MEG3832/Luva_MIDI_por_Mapeamento_Gestual/README.md

# Luva_MIDI_por_Mapeamento_Gestual
Projeto da disciplina de Oficina de Integração 1 de 2025/2
