MEG3832/Luva_MIDI_por_Mapeamento_Gestual/Slides.pptx

OFICINA DE INTEGRAÇÃO

Luva MIDI por Mapeamento Gestual

¹

Integrantes:

Maria Eduarda de Gracia
Rachel Paulino Previtali

1

## Slide 2

INTRODUÇÃO

A Luva MIDI por Mapeamento Gestual busca promover a inclusão de indivíduos com debilidades motoras e combina a expressão musical a movimentos baseados em exercícios fisioterapêuticos para a recuperação muscular e cognitiva.

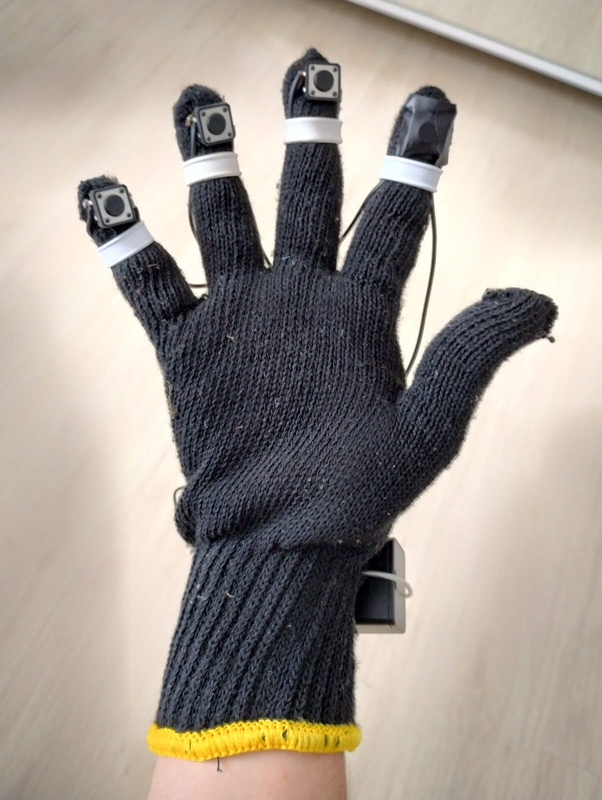
[picture p1: figure]
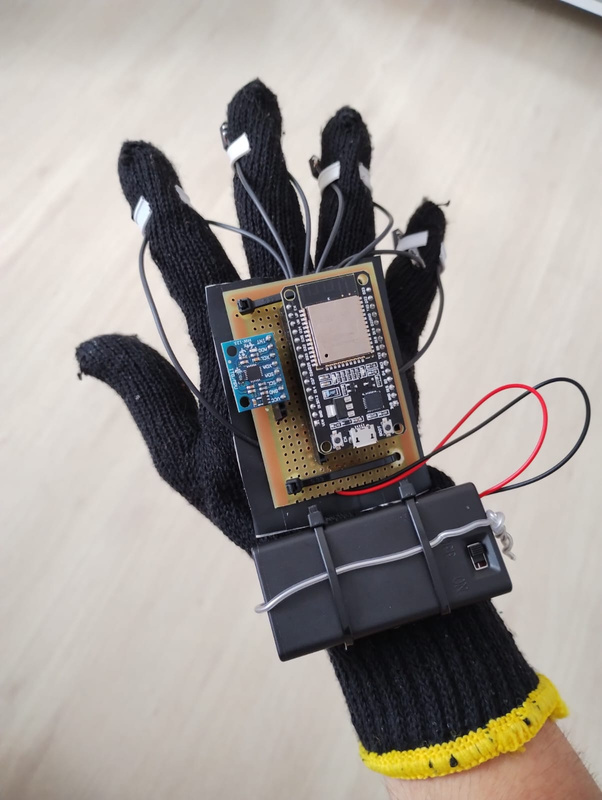
[picture p2: figure]

2

## Slide 3

FUNCIONAMENTO

  - O pressionamento dos botões geram a nota natural (Dó, Ré, Mi, Fá, Sol, Lá e Si)
  - A angulação do pulso gera uma mudança na oitava, ou seja, a nota gerada será mais aguda ou mais grave.

  - A movimentação linear da mão de uma lado para o outro produz o sustenido da nota que está sendo tocada.

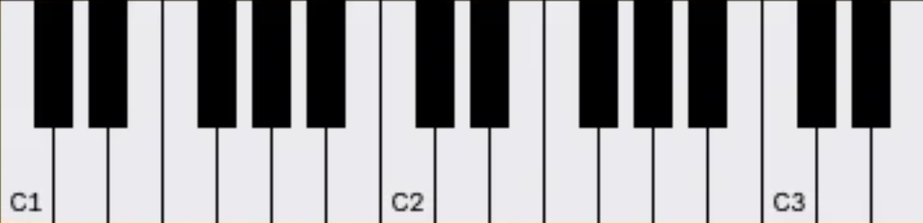
[picture p3: figure]

Mais grave

Mais agudo

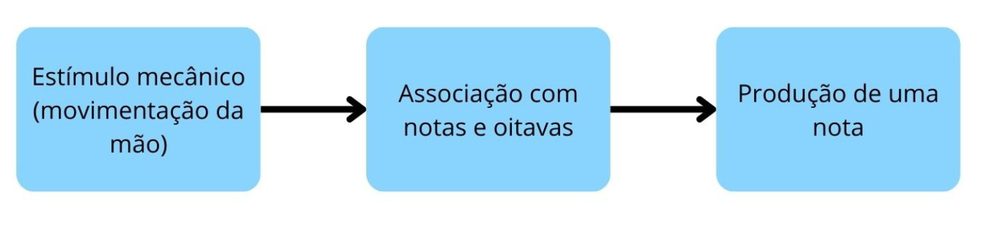
[picture p4: figure]

Fluxograma do funcionamento

3

## Slide 4

DETALHAMENTO DO FUNCIONAMENTO

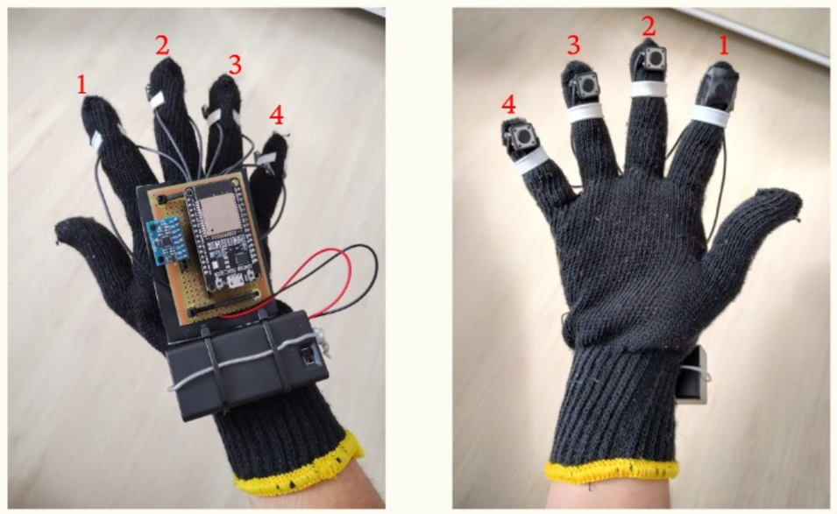
[picture p5: figure]

  - Dedo 1 + Dedo 2 - Sol
  - Dedo 2 + Dedo 3 - Lá
  - Dedo 3 + Dedo 4 - Si

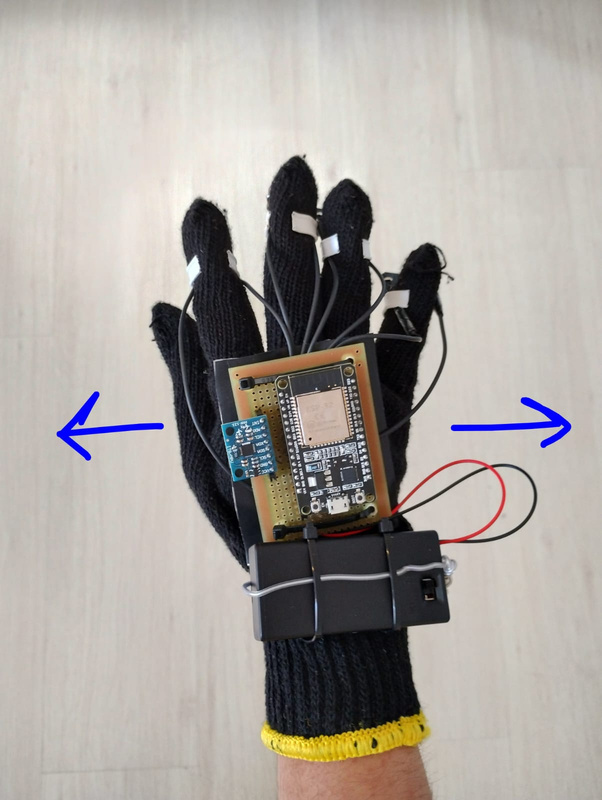
[picture p6: figure]

Ativação do sustenido

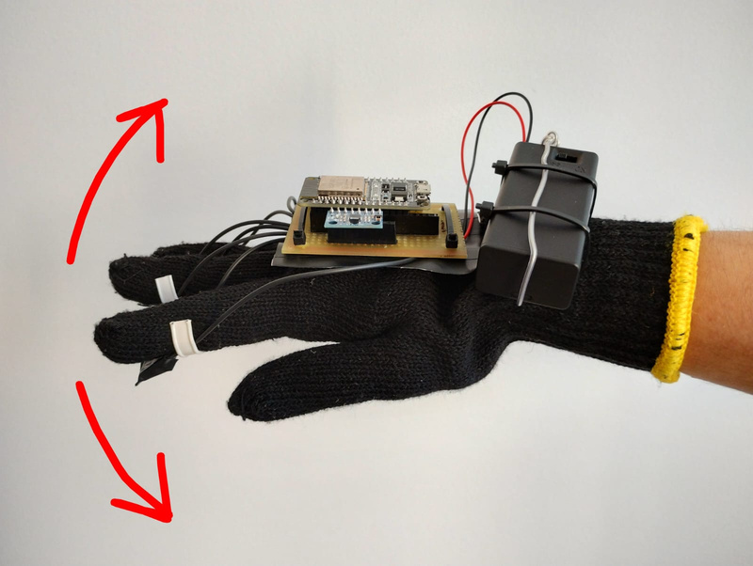
[picture p7: figure]

Mudança de oitava

  - Dedo 1 - Dó
  - Dedo 2 - Ré
  - Dedo 3 - Mi
  - Dedo 4 - Fá

4

## Slide 5

COMPONENTES

Microcontrolador responsável por processar o pressionamento dos botões, processar os inputs da movimentação (lidos pelo MPU) e associá-los com as notas que serão tocadas na interface de áudio.
Também é responsável pela conexão bluetooth com a interface de áudio (app no celular).

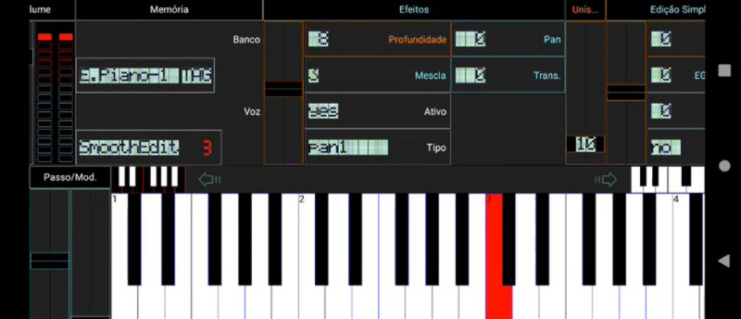
[picture p8: figure]

Aplicativo usado como interface de áudio

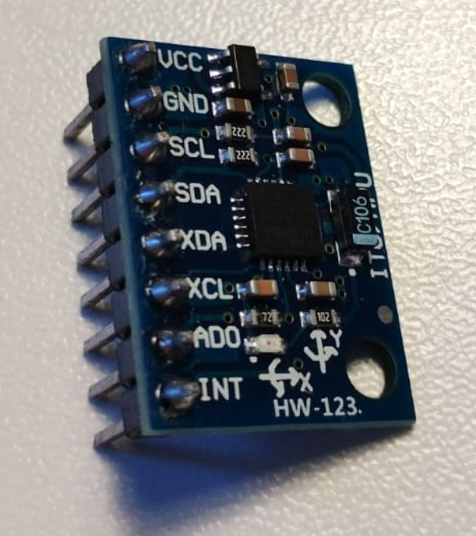
[picture p9: figure]

Sensor que monitora a mudança na angulação, além da aceleração linear

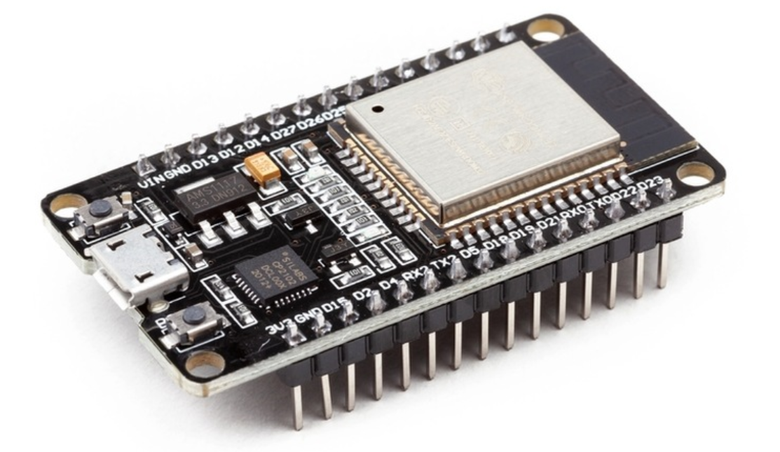
[picture p10: figure]

ESP32

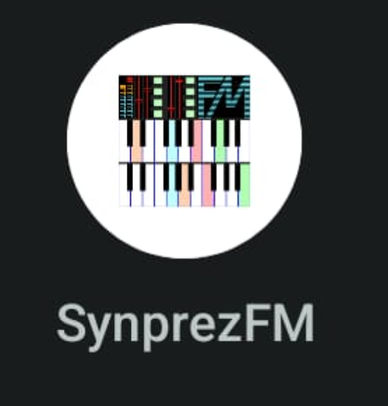
[picture p11: figure]

MPU 6050

5

## Slide 6

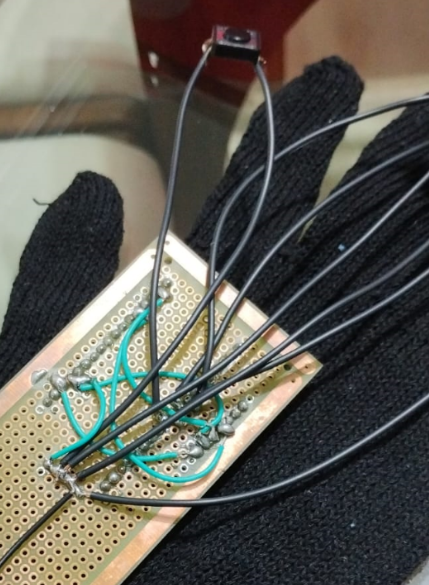
[picture p12: figure]

PCB (Placa universal) e fios

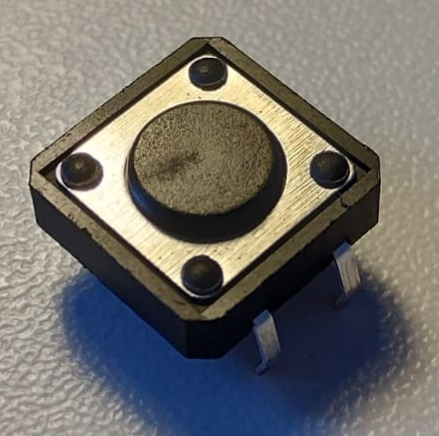
[picture p13: figure]
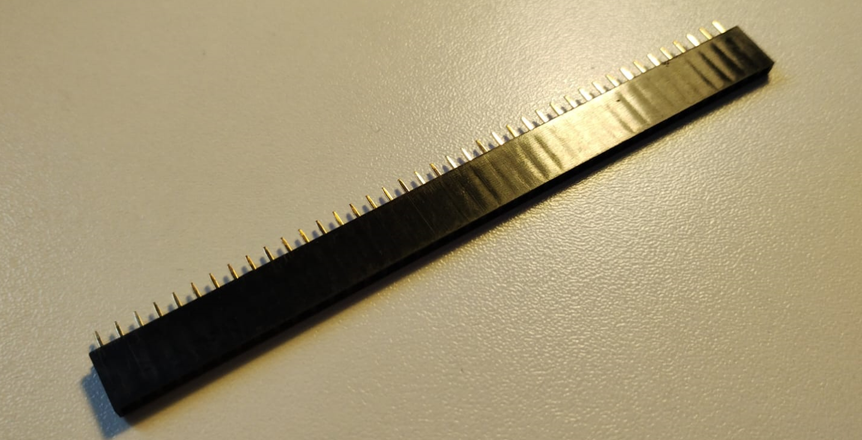
[picture p14: figure]

Conector (suporte)

Push Button

6

## Slide 7

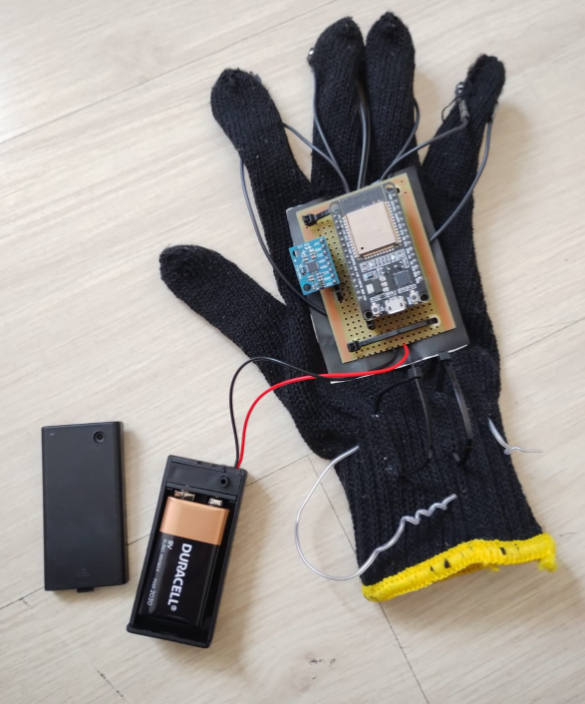
[picture p15: figure]

Bateria de 9V

7

## Slide 8

CIRCUITO

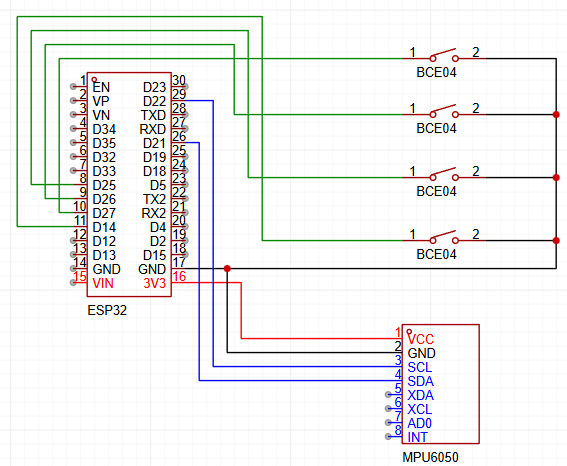
[picture p16: figure]

8

## Slide 9

ORÇAMENTO

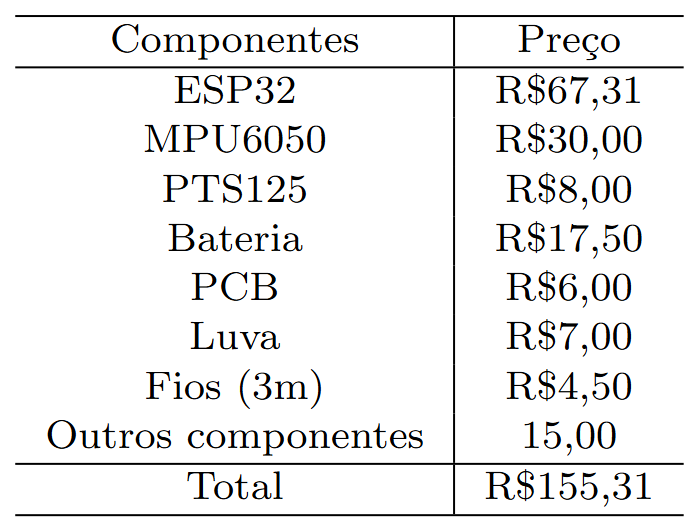
[picture p17: figure]

9

## Slide 10

TRABALHOS RELACIONADOS

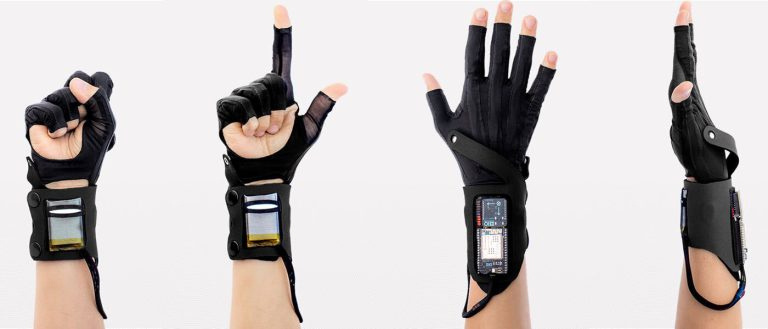
[picture p18: figure]

10

## Slide 11

RESULTADOS

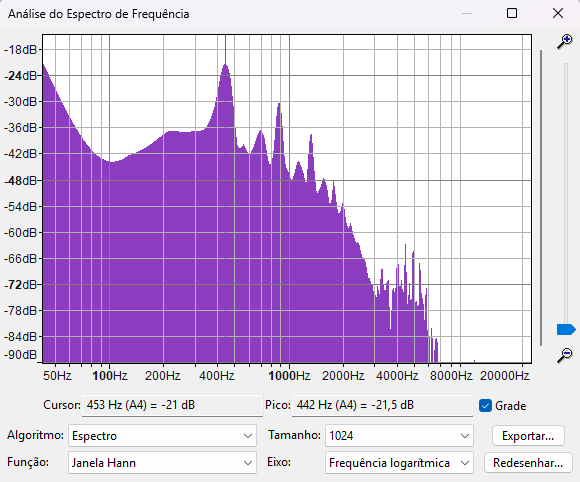
[picture p19: figure]

Gráfico de espectro de frequência, usado para comparar a frequência identificada nas notas do teste e da referência

11

## Slide 12

RESULTADOS

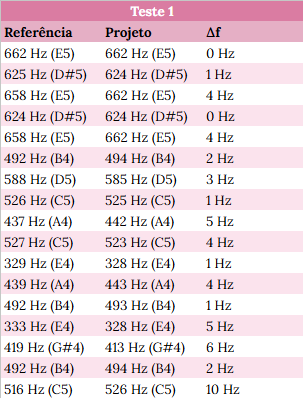
[picture p20: figure]

Tabela com o resultado da análise do gráfico de espectro de frequência de cada uma das notas (tanto da referência quanto do primeiro teste)

12

## Slide 13

RESULTADOS

Faixas de cada som para comparar o tempo de cada nota

13

## Slide 14

RESULTADOS

Faixas de som da referência mais lenta

14

## Slide 15

RESULTADOS

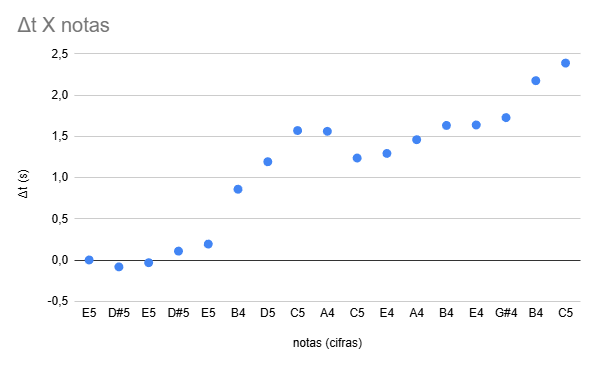
[picture p21: figure]
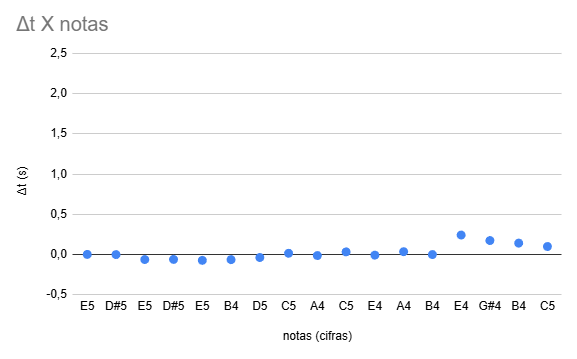
[picture p22: figure]

Gráfico com as variações do tempo para cada nota da primeira referência

Gráfico com as variações do tempo para cada nota da segunda referência

15

## Slide 16

CONCLUSÃO

  - A luva performa satisfatoriamente quanto à produção de algumas notas básicas e seus sustenidos em diferentes oitavas.
  - O projeto mostrou um bom acompanhamento de músicas mais lentas, o que não ocorre em velocidades maiores.
  - O funcionamento da luva é um pouco limitado, devido à sua manipulação, não sendo capaz de executar qualquer música, como o pretendido na proposta deste projeto.
  - Apesar de tudo, o trabalho cumpre com seu proposito de democratização da expressão musical para pessoas com alguma debilidade motora ou impedimento financeiro.

Link para o vídeo no YouTube: https://youtu.be/snMSb20gnNo

16
