MEG3832/Luva_MIDI_por_Mapeamento_Gestual/Slides.pdf

# OFICINA DE

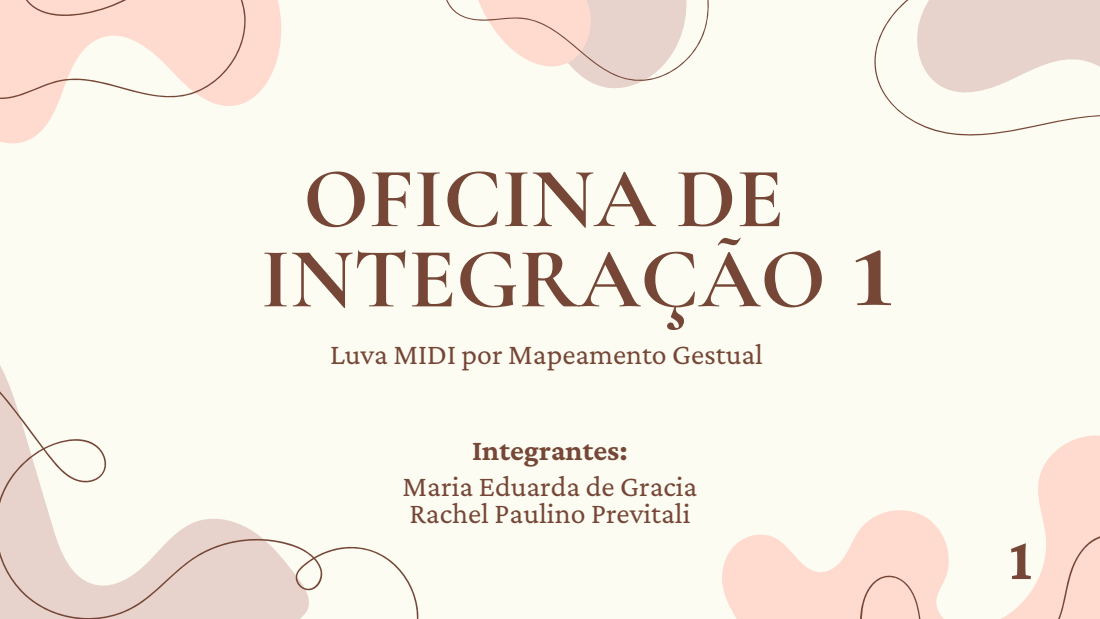
[picture p25: page 1]
INTEGRAÇÃO

Luva MIDI por Mapeamento Gestual

Integrantes:
Maria Eduarda de Gracia
Rachel Paulino Previtali

I

N

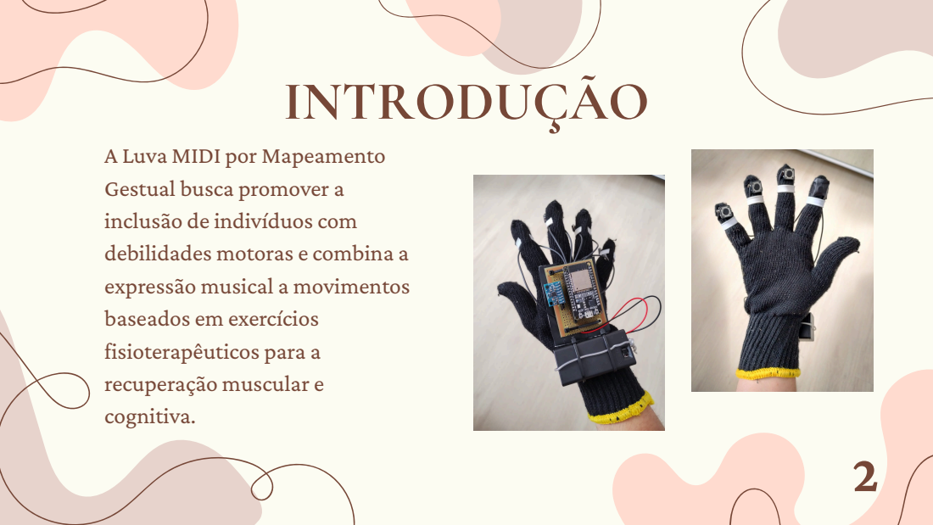
[picture p26: page 2]

# FUNCIONAMENTO

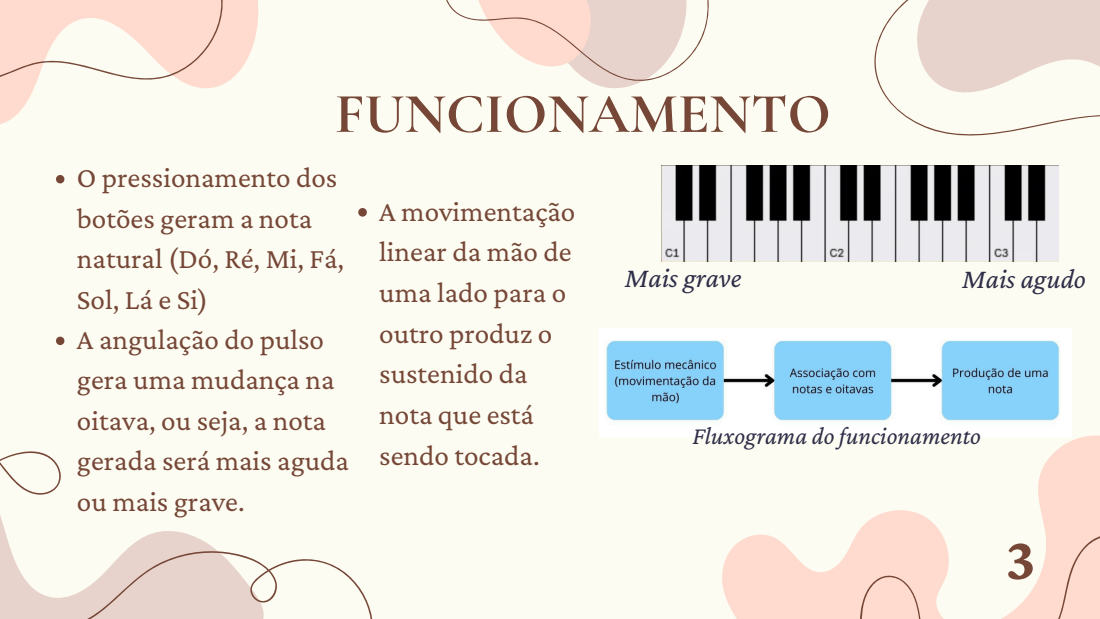
[picture p27: page 3]
Mais grave; Mais agudo

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

Fluxograma do funcionamento

## DETALHAMENTO DO FUNCIONAMENTO

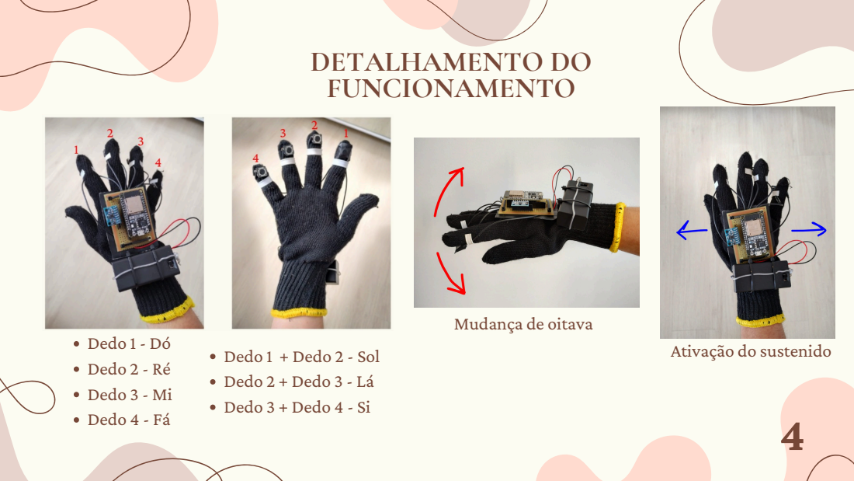
[picture p28: page 4]
Dedo 1 - Dó Dedo 2 - Ré Dedo 3 - Mi Dedo 4 - Fá

Mudança de oitava

Ativação do sustenido

Dedo 1 + Dedo 2 - Sol
Dedo 2 + Dedo 3 - Lá
Dedo 3 + Dedo 4 - Si

# COMPONENTES

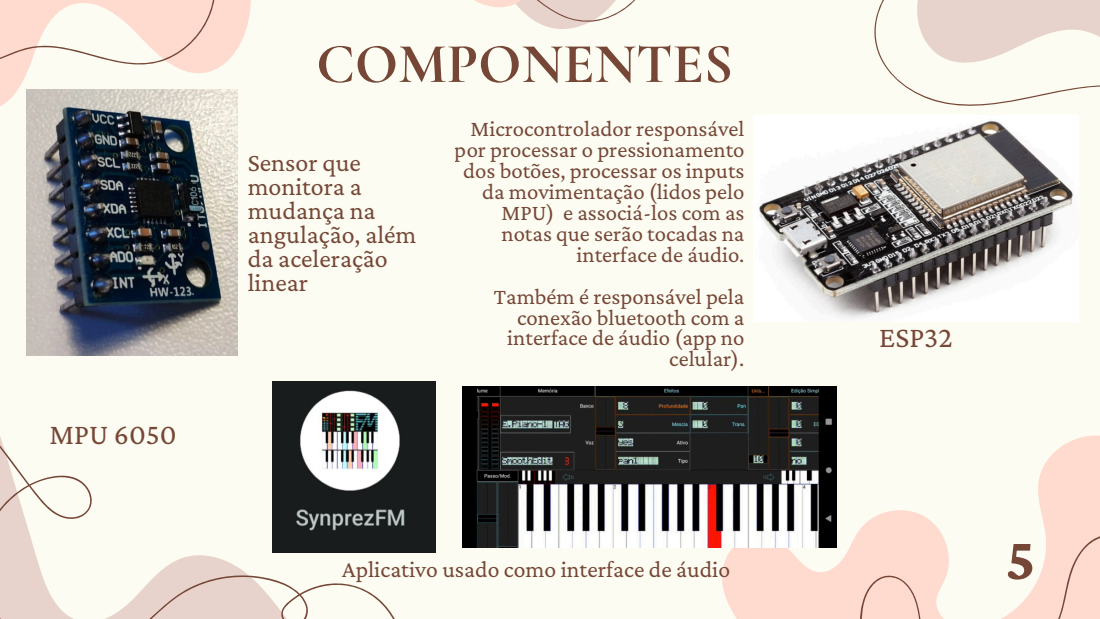
[picture p29: page 5]
MPU 6050; ESP32; Sensor que monitora a mudança na angulação, além da aceleração linear; celular).; Aplicativo usado como interface de áudio

Microcontrolador responsável
por processar o pressionamento
dos botões, processar osinputs
da movimentação (lidos pelo
MPU) e associá-los com as
notas que serão tocadas na
interface de áudio.

Também é responsável pela
conexão bluetooth com a
interface de áudio (app no

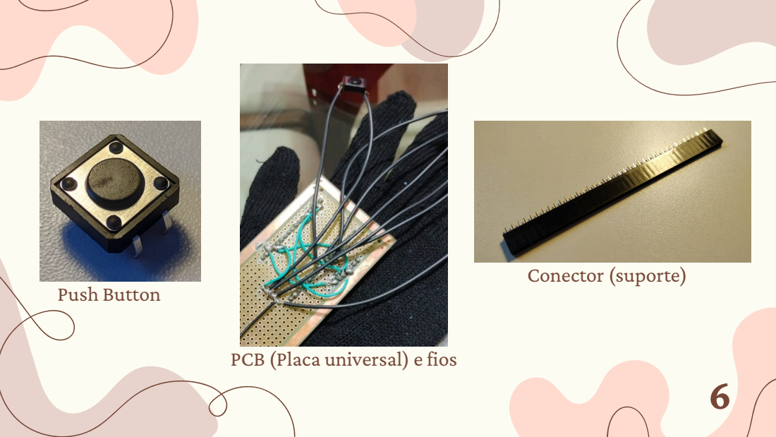
[picture p30: page 6]
Push Button; Conector (suporte)

PCB (Placa universal) e fios

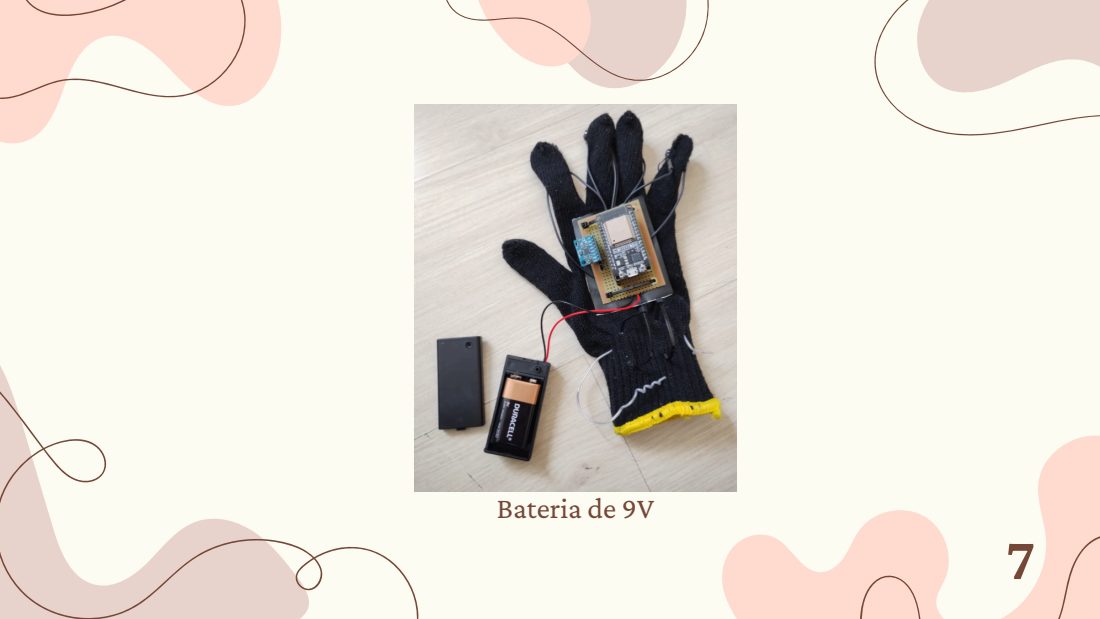
[picture p31: page 7]

# CIRCUITO

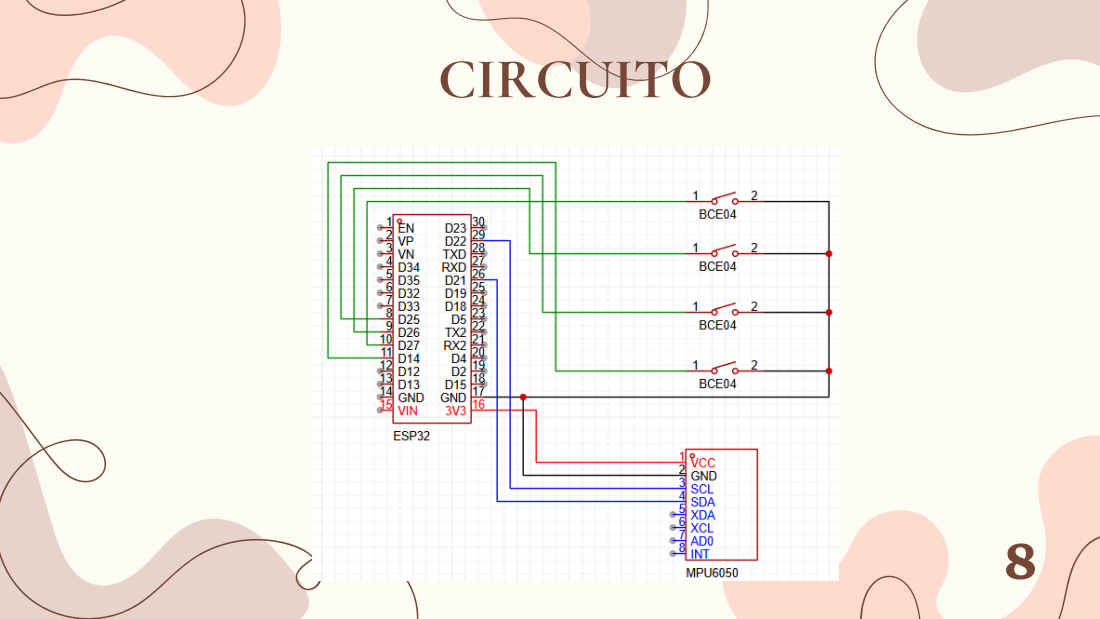
[picture p32: page 8]

# ORÇAMENTO

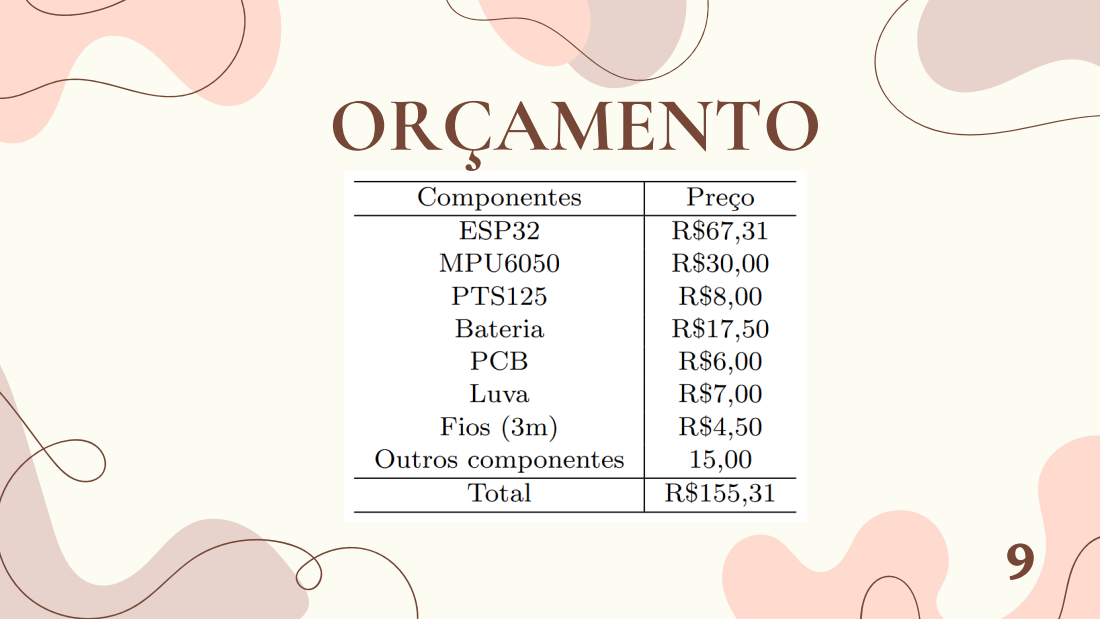
[picture p33: page 9]

# TRABALHOS RELACIONADOS

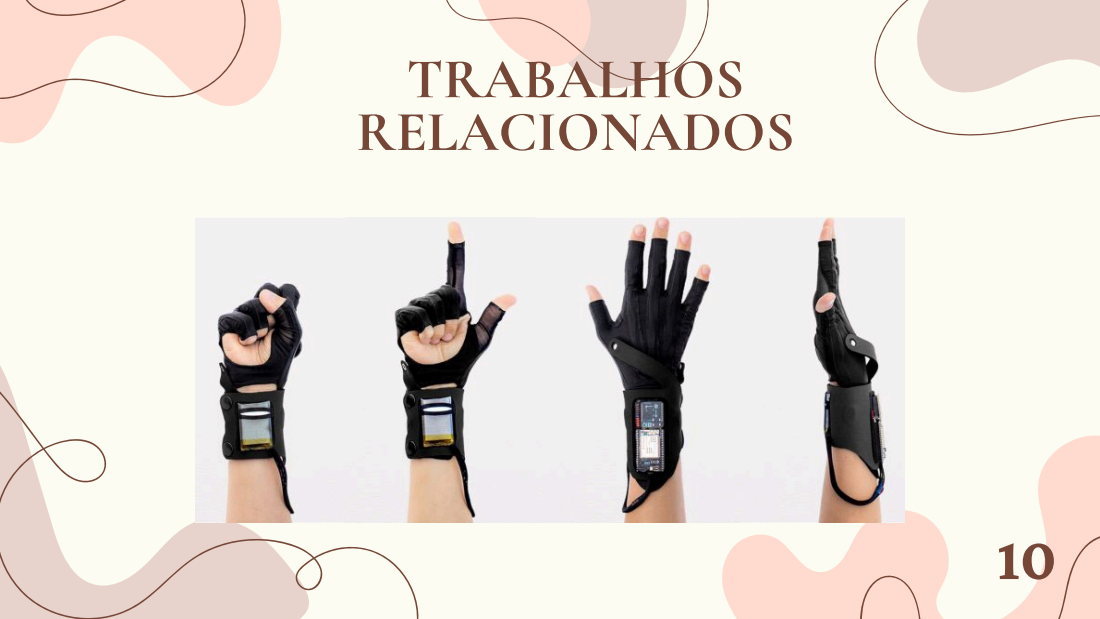
[picture p34: page 10]

# RESULTADOS

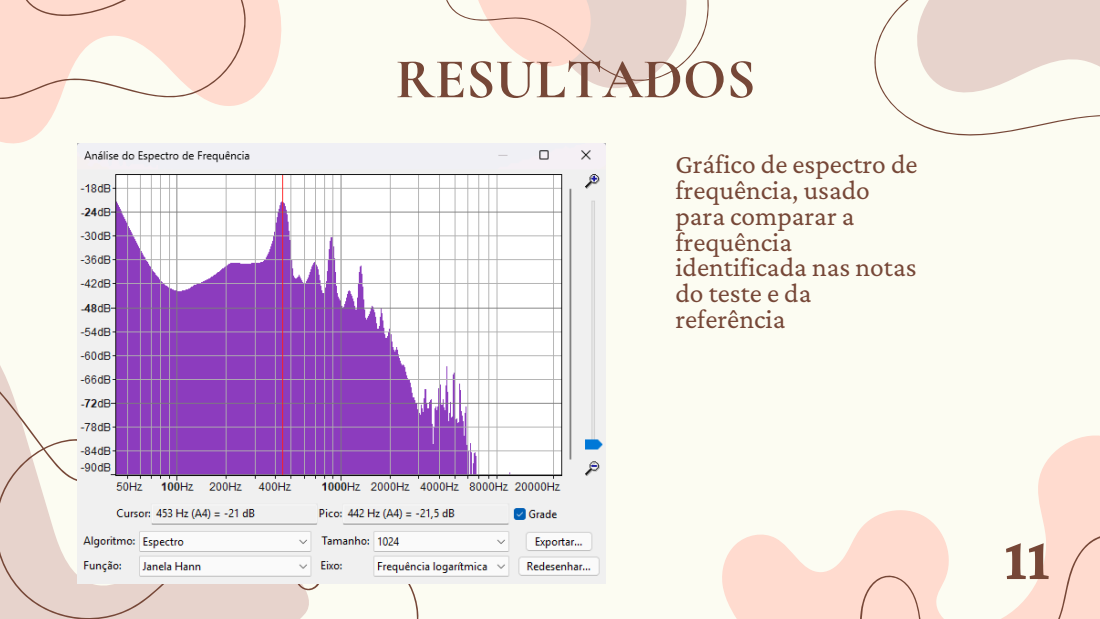
[picture p35: page 11]
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

# RESULTADOS

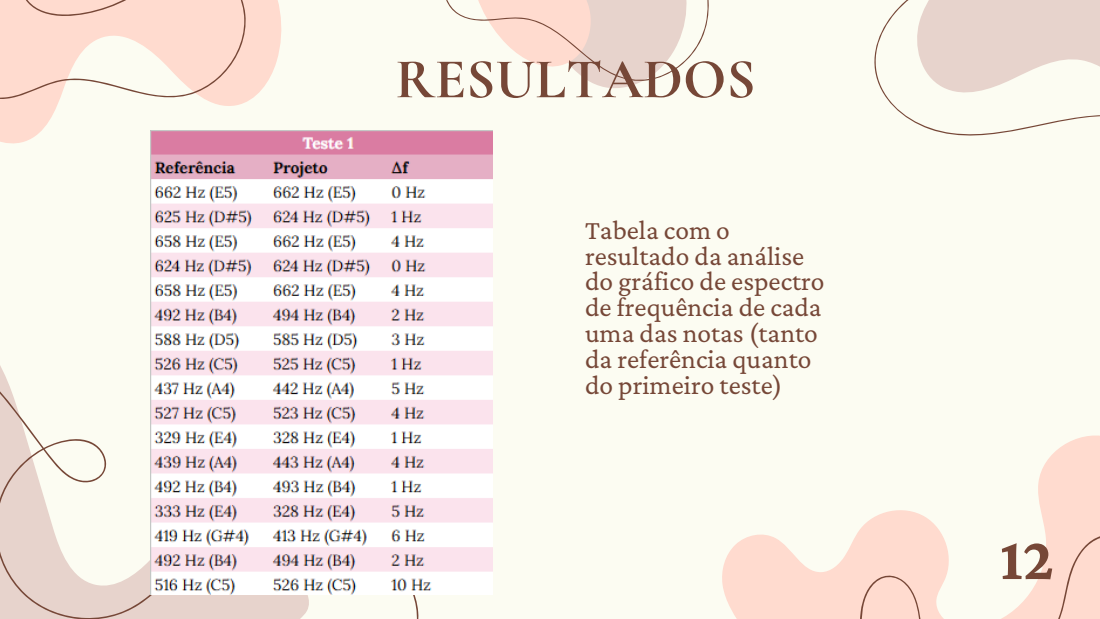
[picture p36: page 12]
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

# RESULTADOS

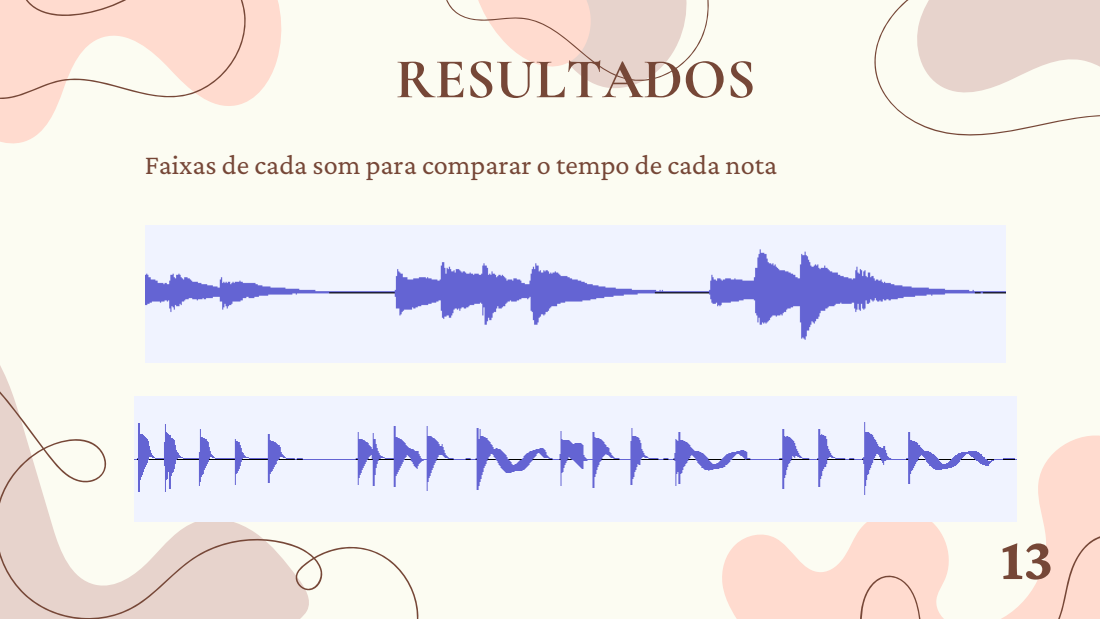
[picture p37: page 13]

Faixas de cada som para comparar o tempo de cada nota

# RESULTADOS

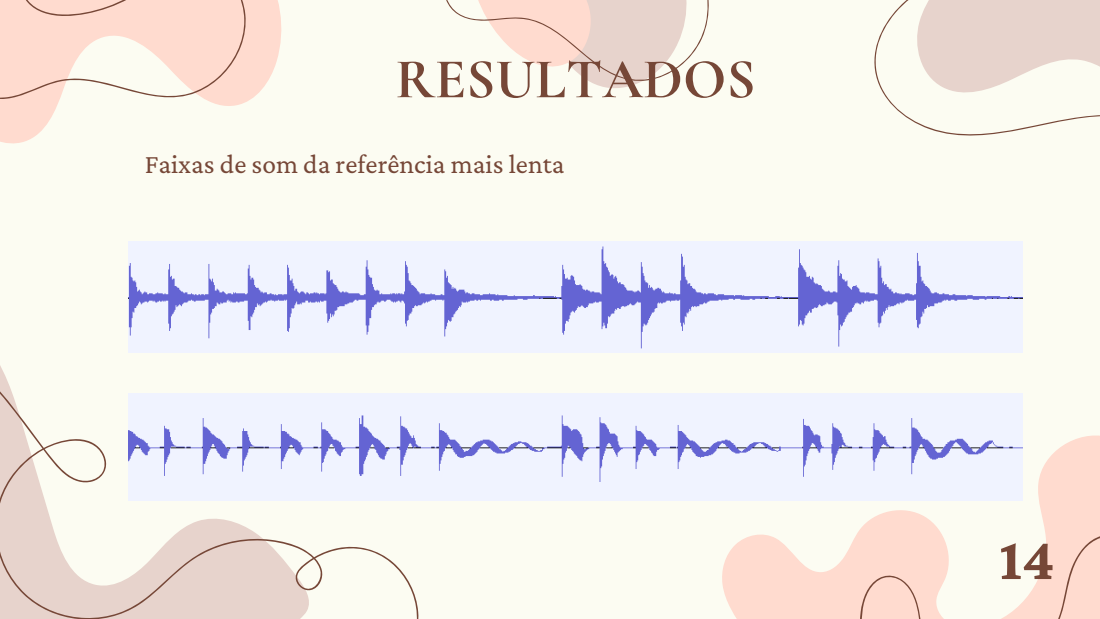
[picture p38: page 14]

Faixas de som da referência maislenta

# RESULTADOS

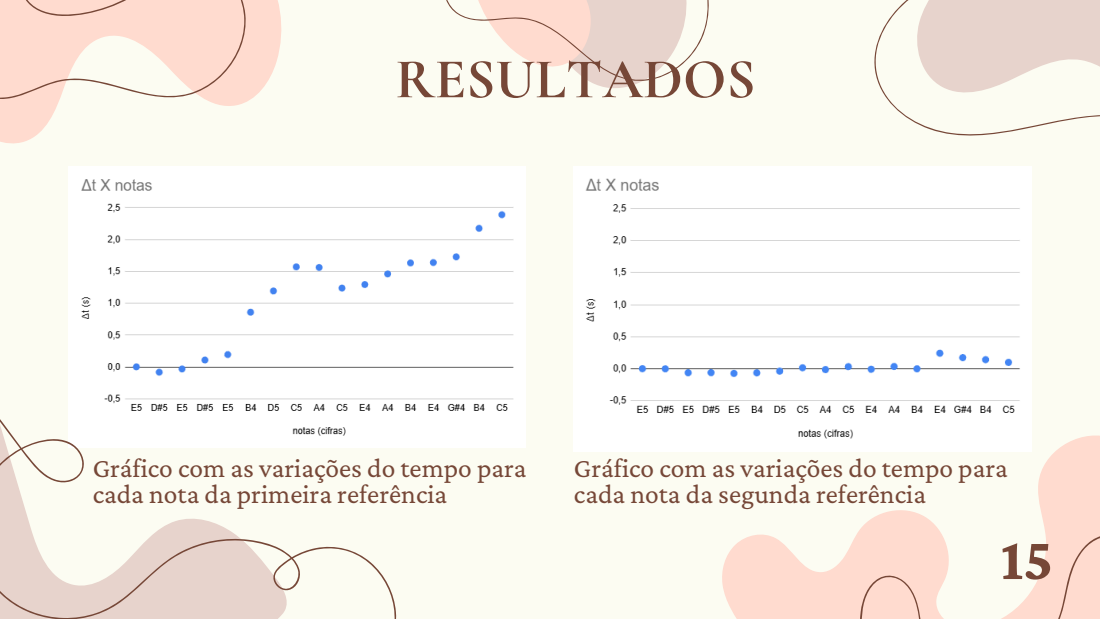
[picture p39: page 15]

Gráfico com as variações do tempo para
cada nota da primeira referência

cada nota da segunda referência

# CONCLUSÃO

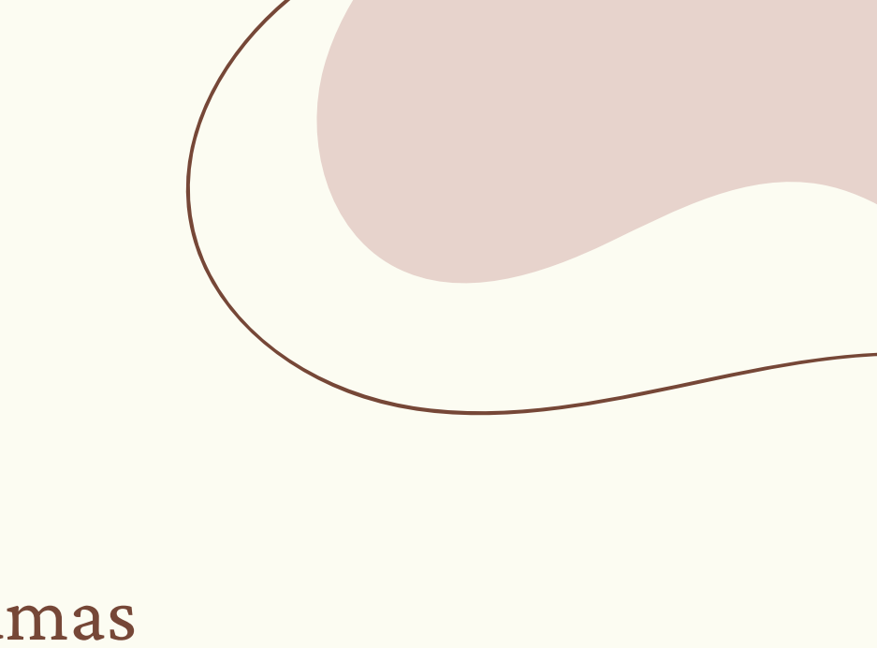
[picture p40: figure]

A luva performa satisfatoriamente quanto à produção de algumas notas básicas e seussustenidos em diferentes oitavas.
O projeto mostrou um bom acompanhamento de músicas maislentas, o que não ocorre em velocidades maiores.
O funcionamento da luva é um pouco limitado, devido à sua

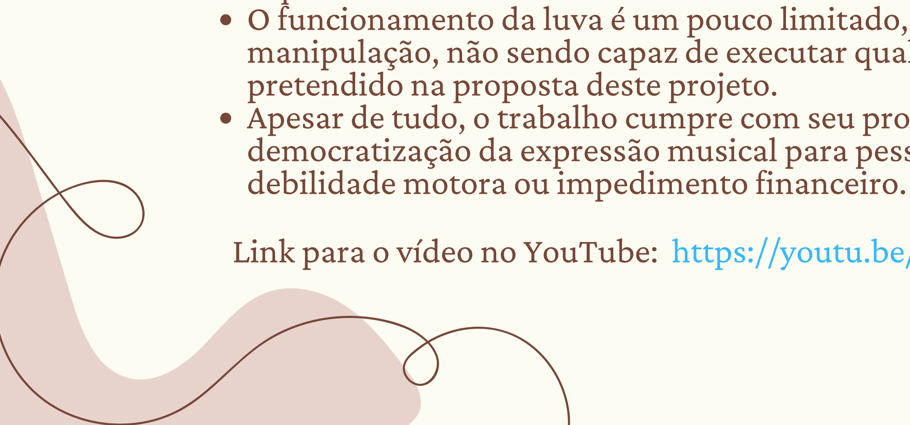
[picture p41: figure]
pretendido na proposta deste projeto.; debilidade motora ou impedimento financeiro.

manipulação, não sendo capaz de executar qualquer música, como o Apesar de tudo, o trabalho cumpre com seu proposito de democratização da expressão musical para pessoas com alguma

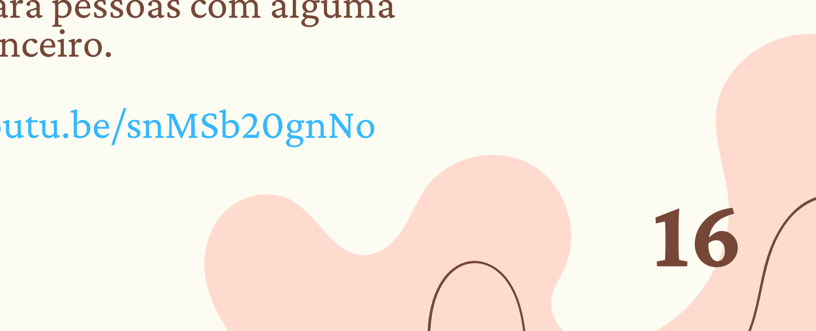
[picture p42: figure]

Link para o vídeo no YouTube: https://youtu.be/snMSb20gnNo
