MEG3832/Luva_MIDI_por_Mapeamento_Gestual/(commit log)

2025-09-09 Programação básica da recepção de dados pelo IMU
2025-09-09 Revert "Programação básica da recepção de dados pelo IMU"
2025-10-05 Add files via upload
    código para o teste da conexão bluetooth do ESP32 com um celular (ou computador) p/ utilizar a interface de áudio
2025-10-19 código p/ acionamento das 7 notas básicas pelo 4 push buttons
